xiixim101-pixel/Projekt---AUTONIMUS/docs/photos/01.jpg

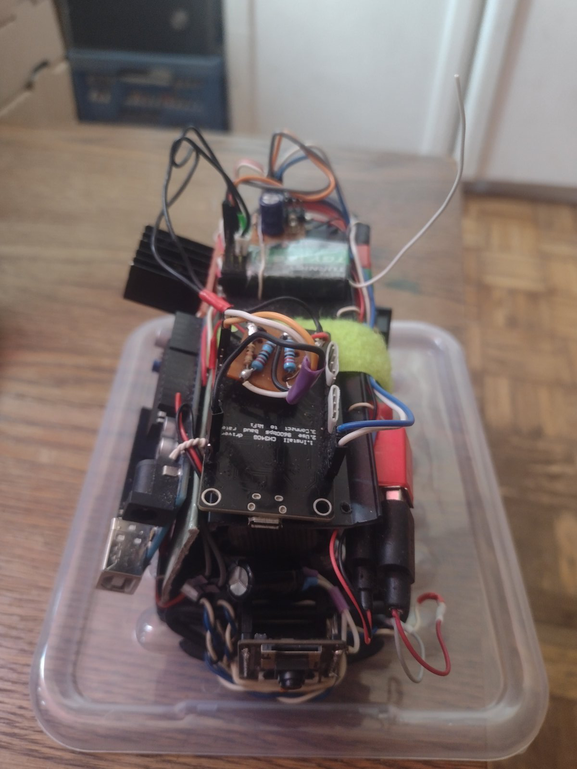
docs/photos/01.jpg
