xiixim101-pixel/Projekt---AUTONIMUS/docs/photos/03.jpg

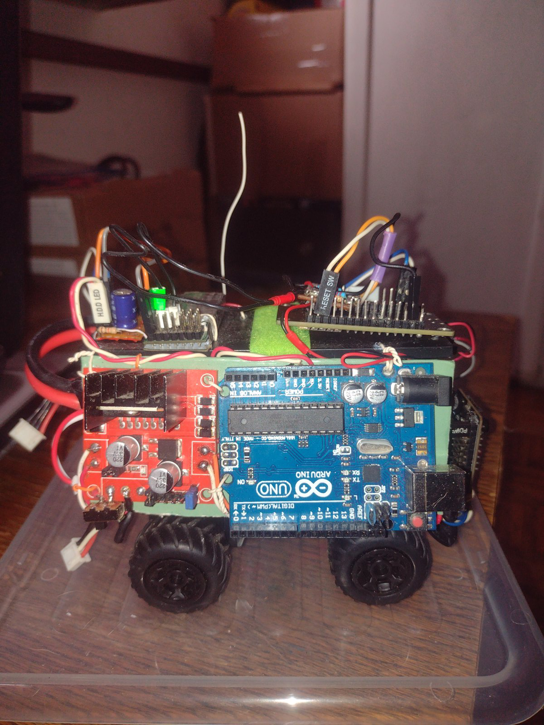
docs/photos/03.jpg
