xiixim101-pixel/Projekt---AUTONIMUS/docs/photos/04.jpg

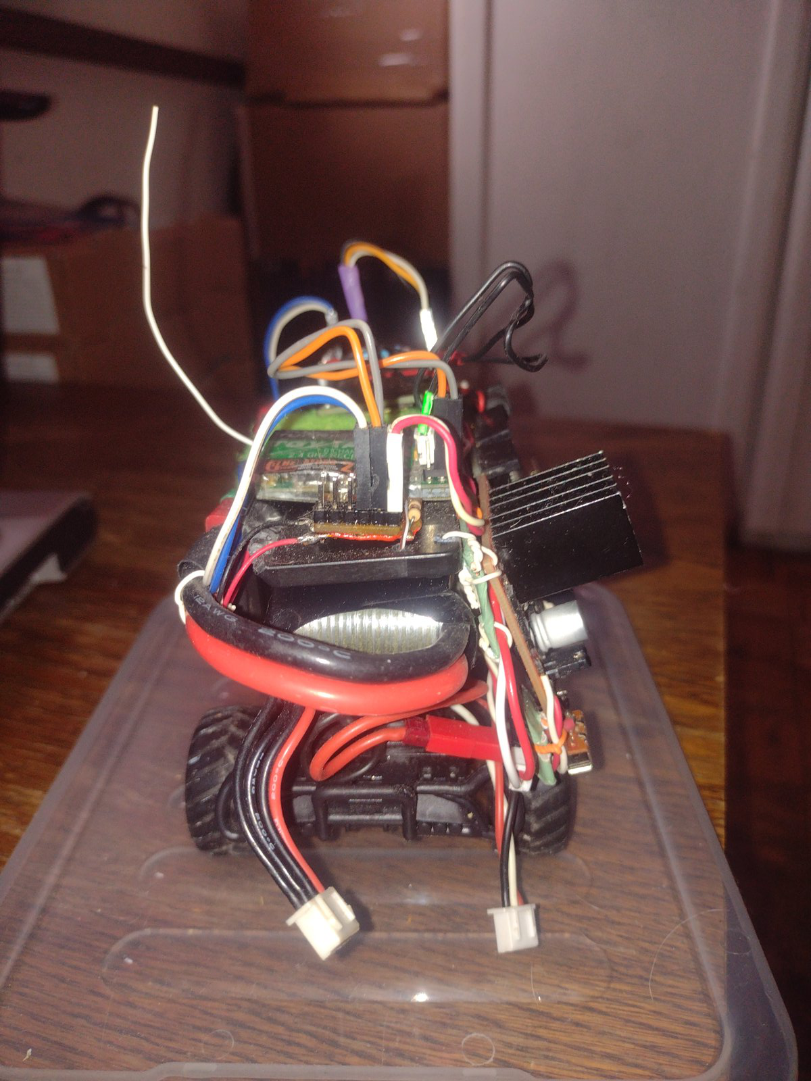
docs/photos/04.jpg
