xiixim101-pixel/Projekt---AUTONIMUS/docs/photos/05.jpg

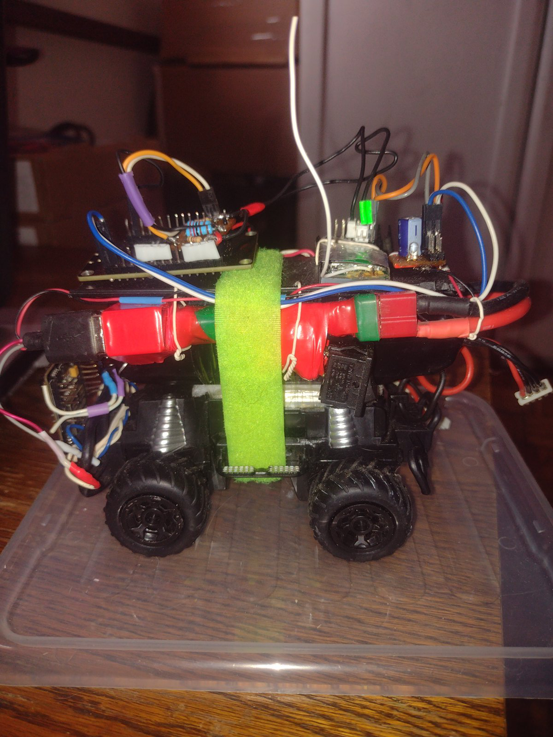
docs/photos/05.jpg
