xiixim101-pixel/Projekt---AUTONIMUS/docs/photos/06.jpg

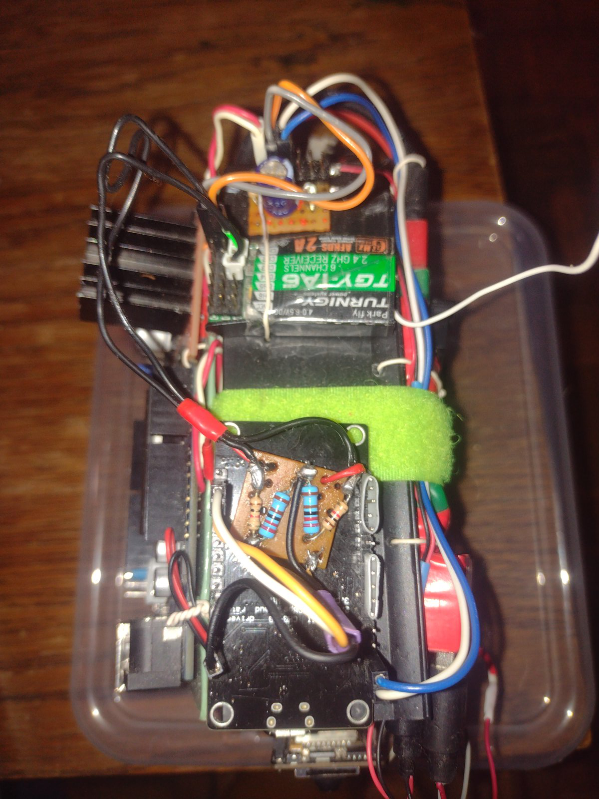
docs/photos/06.jpg
