xiixim101-pixel/Projekt---AUTONIMUS/docs/photos/08.jpg

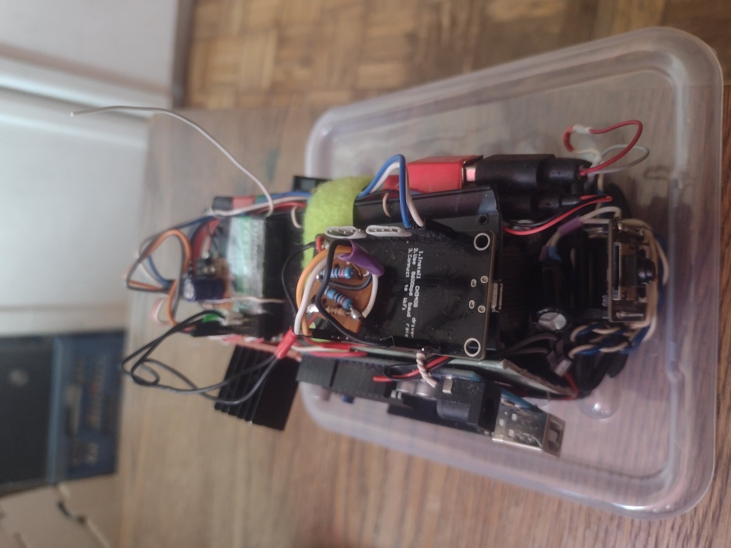
docs/photos/08.jpg
